SinergiaDeveloper1/IOT_Gym4.0/README.md

# IOT GYM 4.0

IOT project of a 4.0 gym prototype
