SinergiaDeveloper1/IOT_Gym4.0/Relazione/report.pdf

Programmazione per l’IoT - Laurea Magistrale in Informatica Applicata - DiSPeA - Universita degli Studi di Urbino Carlo ` Bo
Data di pubblicazione xx/xx/xxxx - DOI: xxxx/xxxxxxx

# 4.0 Gym Prototype

### Luca Cinti¹

### *, Emanuele Lattanzi²

Sommario
In questo elaborato abbiamo cercato di predisporre un’architettura per la raccolta dei dati in una piccola home gym, innanzitutto per verificare la fattibilita nel reperimento di alcune misurazioni, per poi passare all’analisi dei ` dati raccolti, con l’obiettivo di estrapolare delle metriche significative sia ai fini dell’allenamento, che dello studio delle caratteristiche termiche dell’ambiente.
Keywords
IOT — Arduino — ESP32 — MQTT — Gym Metrics

1Laurea Magistrale in Informatica Applicata, Universita degli Studi di Urbino Carlo Bo, Urbino, Italia `
2Docente di Programmazione per l’Internet of Things, Universita degli Studi di Urbino Carlo Bo, Urbino, Italia ` *Corresponding author: l.cinti@campus.uniurb.it

### Introduzione

L’obiettivo preliminare di questo elaborato era verificare la fattibilita dell’allestimento di un sistema di raccolta dati, in ` una piccola home gym, costruendo l’infrastruttura per far comunicare attraverso diversi protocolli una rete di sensori.

Tra le piu disparate metriche di possibile interesse ai fini ` dello studio di una palestra, sono state scelte due categorie di dati: da un lato i quelli relativi all’ambiente di allenamento, dall’altro i dati sull’esecuzione degli esercizi.
Per il progetto corrente sono state dunque prese in analisi le metriche seguenti:
- temperatura e umidita della stanza, prima durante e ` dopo l’allenamento
- variazione di eCO2 e eTVOC (equivalent Total Volatile Organic Compounds)
- accelerazione del bilanciere durante l’esecuzione di un esercizio campione

### 1. Descrizione dell’ambiente

Funzionale alla comprensione di questo elaborato, e la descri- ` zione dell’ambiente in cui e stata allestita la palestra: si tratta ` di una stanza appartenente ad un vecchio immobile disabitato, appositamente ristrutturata, le cui misure sono 5.05 x 4.95 metri, per un’altezza di 3.86 metri.

L’ambiente presenta una finestra, una porta finestra e un’arcata di ingresso sulla quale sono state applicate due tende, fissate con velcro ai lati del muro, come isolante dal resto del locale, in quanto non sono presenti sistemi di riscaldamento centralizzato. Possiamo vederne una panoramica nell’immagine che segue (Figura 2).

Il primo punto di analisi e dunque diretta conseguenza ` di quanto appena detto: analizzare le performance termiche dell’ambiente, per trovare il miglior metodo di riscaldamento durante i mesi invernali.
Collegato a questo vi e il secondo punto in analisi: riscaldan- ` do un ambiente di circa 96 metri cubici, quanto piu possibi- ` le isolato dal resto del locale, abbiamo ritenuto importante monitorare la qualita dell’aria durante l’allenamento. `

### 1.1 La terza metrica

Come abbiamo visto in precedenza, come terzo oggetto di studio e stata presa in analisi l’accelerazione del bilanciere ` durante l’esecuzione di un esercizio campione.
L’esercizio selezionato e la distensione su panca piana, scelto ` in quanto ci garantiva il maggior grado di controllo sull’esecuzione, essendo uno degli esercizi base di ogni allenamento. Ne possiamo vedere uno schema in Figura 1.

La popolarita di tale esercizio ci garantiva inoltre buone ` potenzialita di espansione di questo studio ad un ampio cam- ` pione di tester, nel caso fossimo riusciti a standardizzare il piu` possibile il metodo di acquisizione dei dati.

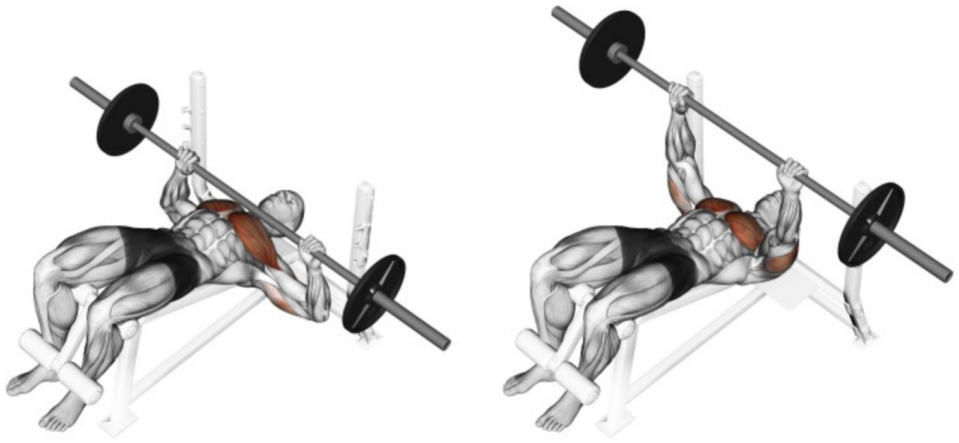
[picture p20: figure]

Figura 1. distensioni su panca piana

### 4.0 Gym Prototype — 2/9

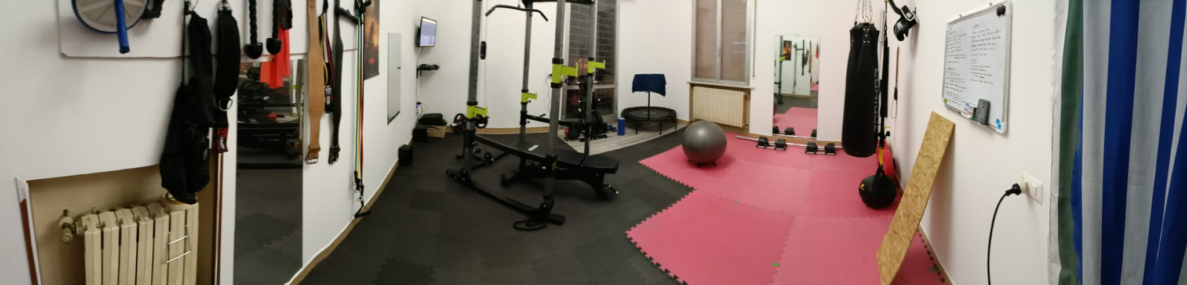
[picture p21: figure]

Figura 2. Visione panoramica dell’ambiente

### 2. Gli strumenti utilizzati

In questa sezione porremo l’attenzione sugli strumenti di indagine utilizzati, sulla loro costruzione, e sulle scelte di progetto e implementazione adottate.

### 2.1 Allestimento dell’infrastruttura

La prima necessita` e stata dunque quella di creare l’infrastrut- ` tura attraverso la quale sarebbe avvenuta la comunicazione dei dati.
A livello di rete e internet sono stati fatti diversi tentativi, prima con due diversi router extender che prolungavano una rete casalinga fino al locale della palestra, e poi con un router con scheda SIM situato direttamente in loco. La prima soluzione e stata scartata in quanto, ad una distanza in linea d’aria dal ` router di casa di circa cinquanta metri, senza considerare i muri, la connessione era troppo instabile.

A questa rete e stato poi collegato un Raspberry Pi 4 che ` ha fatto sia da broker MQTT (di cui parleremo in seguito), che da semplice computer per la raccolta e visualizzazione dei dati, come vediamo in Figura 3.

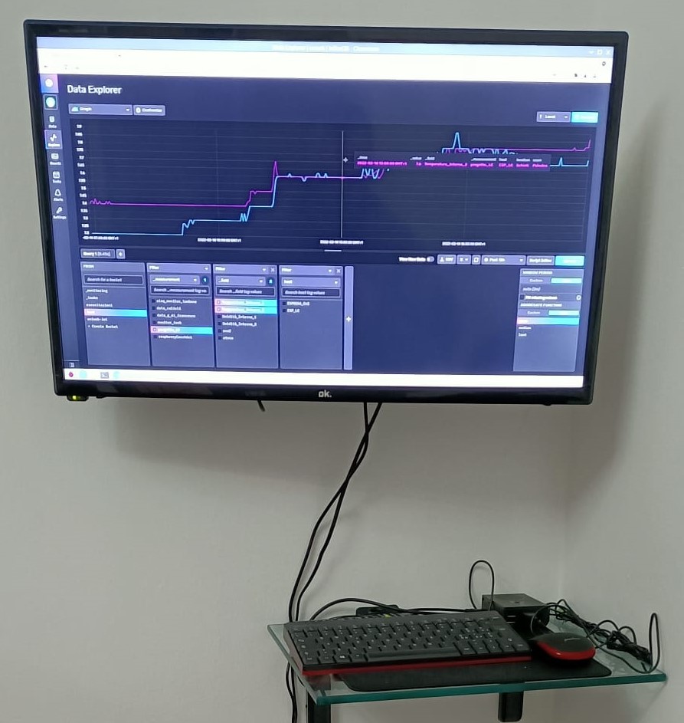
[picture p22: figure]

Figura 3. Raspberry e monitor

### 2.2 I sensori utilizzati

Per raccogliere i dati sono stati utilizzati i seguenti sensori:

- due DHT11 e due DHT22 per temperatura e umidita`
- un CCS811 per eCO2 e eTVOC
- due GY-521 MPU-6050 per l’accelerazione

Si e scelto di collegare gli accelerometri a dei moduli di ` sviluppo ESP32 mini, potendo cos`ı accedere ad un’architettura double core, mentre tutti gli altri sensori sono stati collegati a delle normali ESP8266. Abbiamo adottato sensori DHT11
e DHT22 per temperatura e umidita, potendo cos ` | `ı avere un
confronto nella precisione dei due: vediamo le differenze tra le loro specifiche nella tabella che segue.

Tabella 1. Specifiche DHT

| DHT11 | DHT22
Range umidita | 20-90% | 0-100% `
Precisione umidita | ±5% | ±2% `
Range temperatura | 0-50 °C | -40 +80 °C
Precisione temperatura | ±2% | ±0.5%
Tempo di lettura | 6-10 s | 2 s

Nelle tre immagini che seguono (Figure 4, 5, 6) sono mostrati gli schemi dei circuiti costruiti:


Figura 4. ESP8266 - DHT11/22

### 4.0 Gym Prototype — 3/9

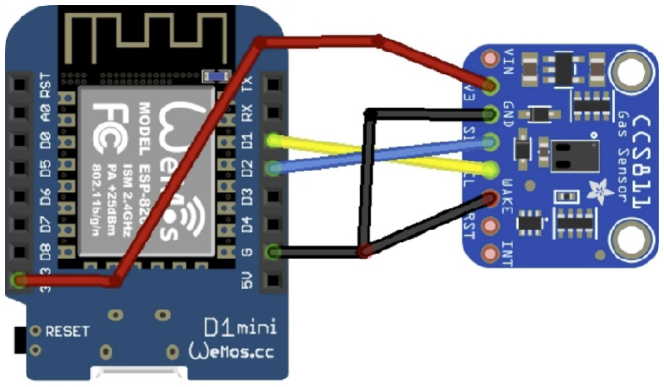
[picture p23: figure]

Figura 5. ESP8266 - CCS811


Figura 6. ESP32 - MPU-6050

### 2.2.1 I sensori per i dati ambientali e il loro obiettivo

Tenendo a mente il primo punto di indagine indicato nell’introduzione, ovvero analizzare i dati ambientali, e doveroso innan- ` zitutto rispondere al perche abbiamo ritenuto delle metriche ´ tuttosommato banali, quali umidita e temperatura, interessanti ` ai fini dell’elaborato.
Come gia detto, il locale non presenta sistemi di riscaldamento ` centralizzato, e, raggiungendo nei mesi invernali temperature interne prossime agli zero gradi centigradi, si e scelto di riscal- ` darlo tramite un generatore di calore a GPL con una potenza di 10 KW, posizionato all’ingresso della palestra, ovvero con la parte frontale dentro il locale, e lo scarico fuori (si faccia riferimento alla Figura 7).

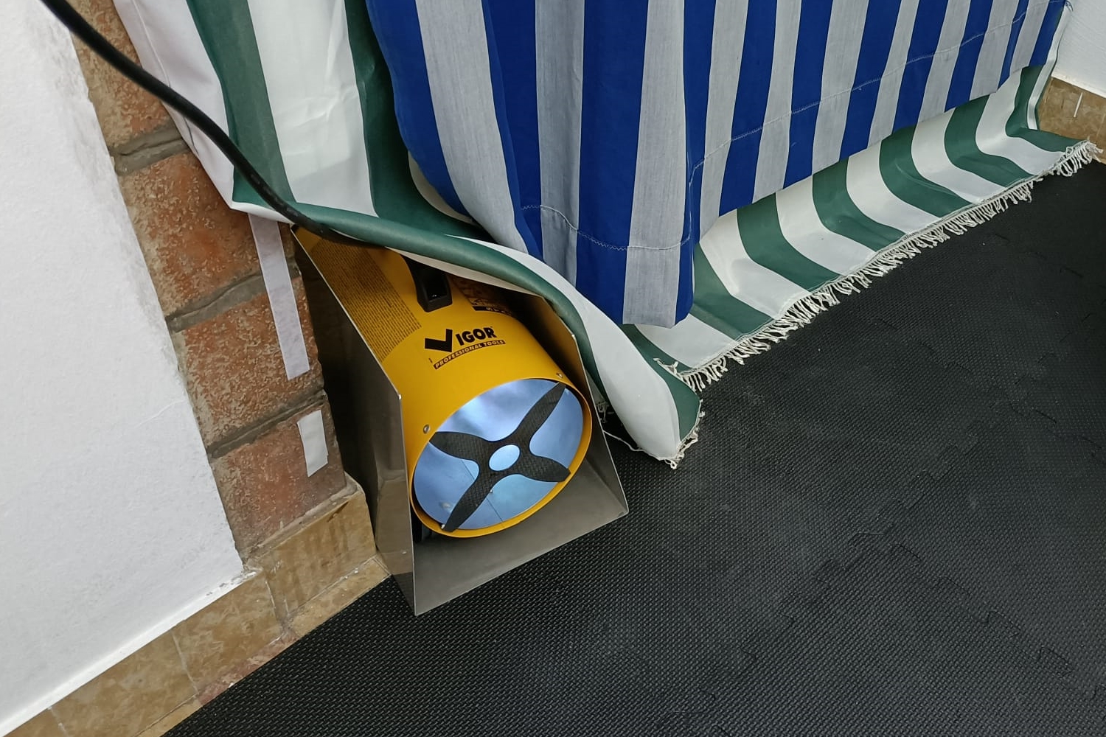
[picture p24: figure]

Figura 7. Termoventilatore GPL

Tuttavia questo presentava altri problemi, sia a livello di sicurezza, trattandosi pur sempre di una combustione in un ambiente chiuso, per quanto la zona di scarico fosse sufficientemente grande e areata, che a livello pratico: il generatore di calore utilizzato e in grado di portare l’ambiente ad una ` temperatura confortevole in tempi contenuti, dell’ordine di dieci/quindici minuti (chiaramente in base alla temperatura di partenza), e dunque necessario spegnerlo per non surriscaldare ` l’ambiente. Questo comporta pero un crollo della temperatura `
pressoche immediato. Si ´ | e scelto dunque di inserire una stufa `
da 3 KW il cui compito e quello di mantenere la temperatura ` costante.
Alla luce di quanto detto, assume ancora piu importanza la se- ` conda metrica oggetto di studio, ovvero la variazione di eCO2 e eTVOC (equivalent Total Volatile Organic Compounds), come monitor indiretto della qualita dell’aria. `
Importante ricordare a tal proposito che il sensore CCS811 non misura direttamente l’anidride carbonica o i composti
organici volatili, ma misura la quantita equivalente di impurit ` | a`
nell’aria per ottenere quelle letture del sensore: in altre parole, il sensore legge determinati dati di qualita dell’aria, tali dati ` possono essere dati dalla presenza di CO2, o da composti organici equivalenti capaci di dare quel tipo di letture. E una ` sottigliezza ininfluente ai fini dell’elaborato, ma per dovere di chiarezza ne abbiamo ritenuto necessaria la precisazione.

Data questa premessa passiamo ora a descrivere le relative scelte di progetto.
Fare uno studio accurato delle performance termiche di un ambiente richiede una grande quantita di dati, sia a livello di ` caratteristiche ingegneristiche e architettoniche dell’ambiente, che dei materiali di costruzione, informazioni alle quali non avevamo completo accesso. Potevamo tuttavia estrapolarle e farne una buona stima, sia attraverso l’analisi in loco di periti tecnici, che dai dati restituiti dai sensori.
Il dato che si e scelto di ricercare ` | e la dispersione del `
calore dall’ambiente, che costituisce un buon aggregato e indice delle performance termiche della stanza.
Per ottenere tale informazione si e scelto di utilizzare i quattro ` sensori DHT come segue: due sono stati posizionati a due angoli della stanza, per ottenere la temperatura media interna, uno fuori dall’edificio per la temperatura esterna, e uno appena fuori dall’ingresso della palestra, comunque in un ambiente interno, ma non riscaldato.
Le due postazioni di rilevamento di temperatura e umidita` esterne alla stanza, non avendo accesso a prese elettriche, sono state implementate con batteria e un con meccanismo di deep sleep per il risparmio energetico. I relativi circuiti sono stati quindi dotati di collegamenti per una batteria da 650 mA e di un jumper per consentire la programmazione del modulo.

### 2.2.2 Gli accelerometri e il loro obiettivo

Un discorso a parte va fatto per gli accelerometri, che per noi costituivano l’argomento di maggiore interesse di questo studio.

### 4.0 Gym Prototype — 4/9

Innanzitutto e necessario chiarire l’obiettivo dell’analisi, ov- ` vero cercare di registrare se, nell’esecuzione di un qualsiasi esercizio che coinvolga il sollevamento di un bilanciere, si rilevano delle imperfezioni, da cogliere attraverso le differenze nelle accelerazioni agli estremi dell’attrezzo: se un accelerometro posto a un estremo del bilanciere, avesse riscontrato accelerazioni diverse da quelle registrate all’estremo opposto, sarebbe stato possibile individuare degli errori nell’esecuzione dell’esercizio, dandoci cos`ı un feedback sulla qualita dello ` stesso, ed eventuali indicazioni per migliorarlo.

Con questo obiettivo in mente abbiamo ritenuto imprescindibile che entrambi i moduli fossero alimentati a batteria, per evitare perturbazioni nelle misurazioni dovute ad eventuali interferenze dei fili di alimentazione. Questo ha pero` aumentato la difficolta nella costruzione del ”sistema accele- ` rometro”, che includendo ora anche una batteria, diventava piu ingombrante e difficilmente stabilizzabile sul bilanciere. `

La soluzione che abbiamo adottato e stata quella di pro- ` gettare delle scatole di plastica, appositamente disegnate in base alle misure del modulo ESP32 col sensore e la batteria, stampate in 3D. Per minimizzare le vibrazioni e i movimenti interni alla scatola, sono stati poi inseriti degli spessori in gommapiuma e dei tappi in plastica, aumentando cos`ı la stabilita` del sistema. Ogni scatola presenta inoltre un foro per accedere alla porta USB dell’ESP32 per le future programmazioni del modulo.
Ne possiamo vedere il risultato nella Figura 8.

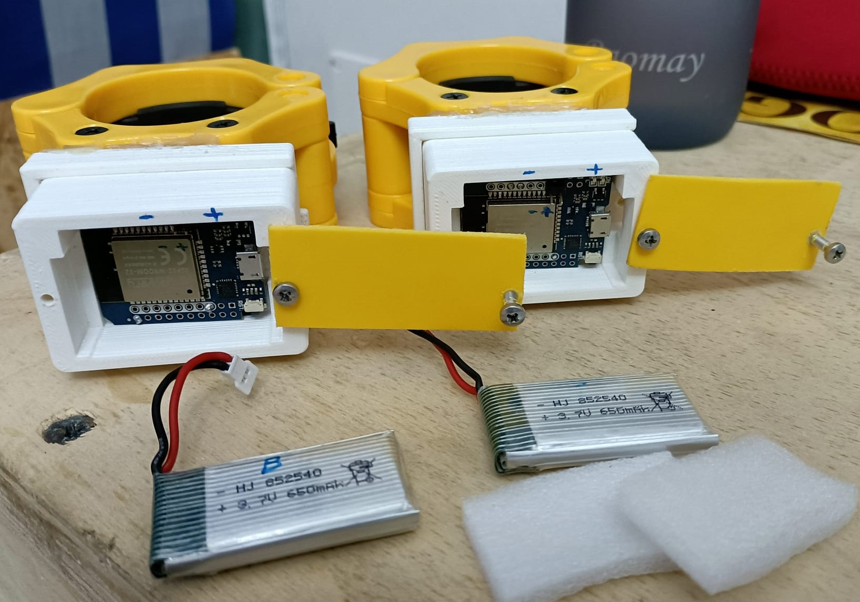
[picture p25: figure]

Figura 8. Scatola con accelerometro

Queste scatole sono state poi fissate agli anelli di bloccaggio dei dischi al bilanciere, come vediamo in Figura 9. Aggiungiamo inoltre che i bilancieri utilizzati per questi test sono bilancieri standard olimpici, di cui riportiamo le misure nell’immagine che segue (Figura 10), che hanno, e questo vedremo in seguito che risultera critico, la caratteristica ` di avere la zona di fissaggio dei pesi capace di ruotare attorno all’asse del bilanciere.
Tale accorgimento tecnico si utilizza per minimizzare la ro-

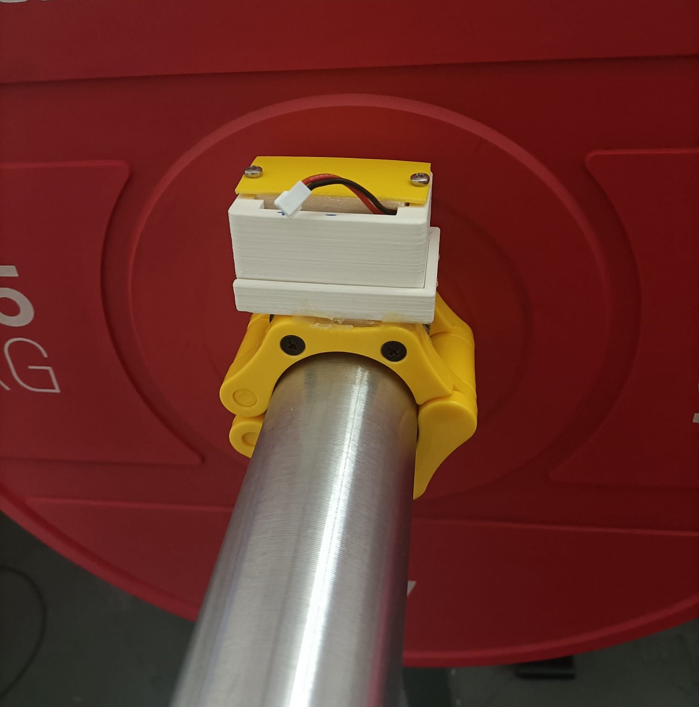
[picture p26: figure]

Figura 9. Anello di bloccaggio dischi su bilanciere

tazione, e le conseguenti accelerazione e variazione di momento angolare del sistema, in fase di movimento del carico: un’improvvisa rotazione del bilanciere attorno al suo asse orizzontale non comporta cos`ı la rotazione dei pesi (o comunque la riduce significativamente), che causerebbe maggiore instabilita nell’esercizio. `

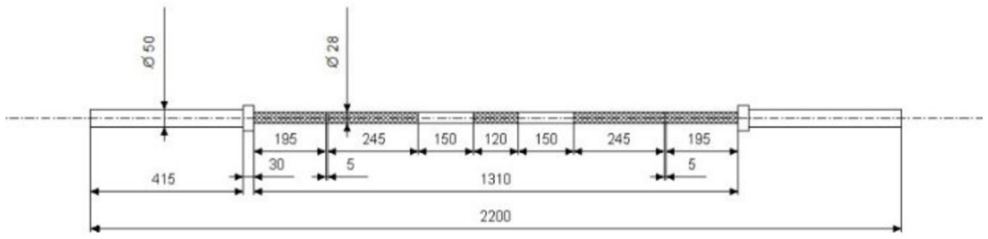
[picture p27: figure]

Figura 10. Misure bilanciere olimpico

Prima di passare alla raccolta e analisi dei dati ci e do- ` veroso aggiungere che tutti i microcontrollori sono stati programmati tramite Arduino. Eventuali particolarita o dettagli ` specifici di implementazione saranno affrontati in fase di analisi dei dati.
Tutto il codice e comunque consultabile nella repository Gi- ` tHub indicata in bibliografia.

### 3. Raccolta dati

I dati sono stati raccolti su un server remoto sul quale e stato ` installato influxdb, un database open source per serie temporali, particolarmente adatto ad applicazioni IOT.

Dei sette sensori di cui si e discusso, cinque comunicava- ` no tramite il modulo WiFi del microcontrollore collegandosi direttamente al server remoto.

Per i due moduli con DHT11 posizionati fuori dalla palestra, quello interno al locale, e quello esterno all’edificio (per maggior chiarezza si faccia riferimento alla pianta del locale in Figura 11) si e optato per una soluzione differen- ` te: essendo alimentati a batteria, abbiamo scelto di utilizzare due tecnologie particolarmente adatte al risparmio energetico.

### 4.0 Gym Prototype — 5/9


Figura 11. Pianta della palestra. Non in scala

Come protocollo di comunicazione si e scelto MQTT (Mes- ` sage Queuing Telemetry Transport), particolarmente meno energivoro del classico WiFi, con il Raspberry Pi 4, come precedentemente detto, che funge da broker, e i due sensori da client.
Per l’invio dei dati su influxdb e stato poi appositamente con- ` figurato su Raspberry un plugin telegraf.
La seconda tecnologia per il risparmio energetico e pi ` u che ` altro un accorgimento a livello implementativo: invece di programmare i sensori con la classica modalita, ovvero in loop `
continuo, si e scelto di adottare il ` | deep sleep, ovvero al termi-
ne di ogni lettura e invio dati, i moduli vengono letteralmente addormentati, lasciando attivo il Real Time Clock (RTC), che si occupa di risvegliare il sistema dopo un intervallo di tempo programmabile.
Nel nostro caso abbiamo visto che la durata della batteria, con questo accorgimento, e praticamente decupliata, passando da ` circa cinque ore a oltre due giorni.
Nell’immagine che segue (Figura 12) vediamo uno dei due sensori in oggetto.

### 4. I dati ambientali durante l’allenamento

Premettiamo che tutti i dati sono disponibili sia in forma aggregata che estensivamente nella repository GitHub indicata in bibliografia, oltre ad essere consultabili direttamente sul server influxdb.

Passiamo ora vedere i dati raccolti, relativi ad una data campione particolarmente indicativa, in cui e stata utilizzata ` la palestra. Alleghiamo i grafici estratti da influxdb nelle immagini che seguono (Figure 13, 14, 15), e condensati nella

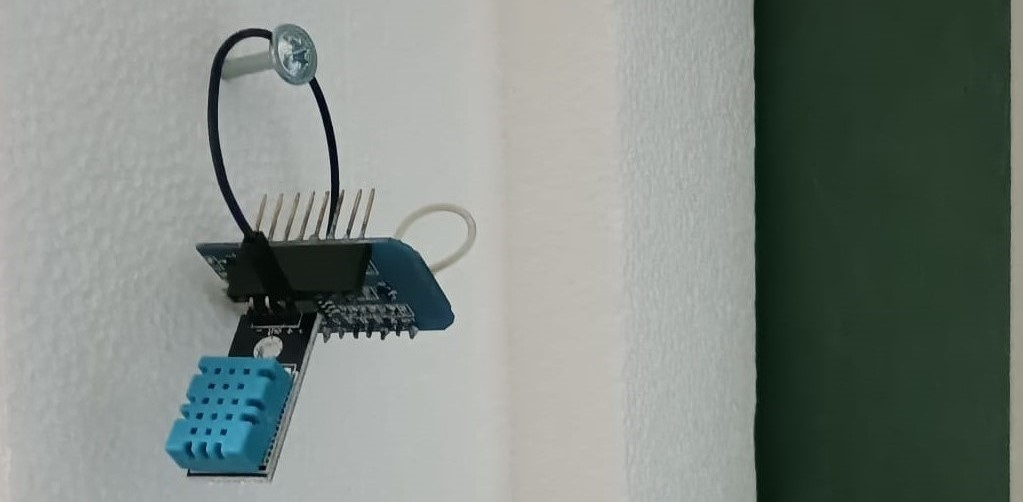
[picture p28: figure]

Figura 12. Sensore DHT11 fuori dall’ingresso della palestra

tabella in Figura 16.


Figura 13. Temperatura in gradi Celsius


Figura 14. Umidita in percentuale `

Le linee azzurre e viola sono relative ai due sensori interni, quella arancio al sensore fuori dall’ingresso, quella magenta al sensore esterno.

### 4.1 Analisi dei dati ambientali

Iniziamo questa analisi da una descrizione piu approfondita ` dei grafici precedentemente allegati.
Come possiamo vedere in tabella, sono stati indicati dei timestamp significativi:
- 18:55, inizio dell’allenamento e accensione di stufa e generatore di calore
- 19:08, spegnimento del generatore di calore

### 4.0 Gym Prototype — 6/9


Figura 15. eCO2 in ppm e eTVOC in ppb


Figura 16. dati condensati in timestamp significativi

- 19:30 e 19:01, due intertempi per mostrare l’andamento durante l’allenamento
- 20:27, spegnimento della stufa
- 20:37, fine allenamento

La variazione piu importante in tutti gli indicatori avviene ` mentre il generatore di calore a GPL e acceso; vediamo infatti ` che le temperature interne hanno una rapidissima crescita,
parallela ad un crollo dell’umidita. Molto positivo ` | e inoltre `
il fatto che la qualita dell’aria non degradi troppo significati- ` vamente, registrando solo un picco nella quantita di anidride ` carbonica (e/o suoi composti equivalenti), comunque inferiore a qualla generata dal metabolismo durante l’allenamento. Particolarmente interessante risulta l’andamento della temperatura registrata dal sensore posizionato appena fuori dall’ingresso della stanza (linea arancio del grafico in Figura 13), che in questa fase presenta a sua volta un aumento, mostrando chiaramente, come era intuibile, i problemi di isolamento termico dovuti alla separazione degli ambienti ottenuta soltanto tramite due tende in tessuto sintetico.
Il discostamento tra i valori della temperatura interna e invece ` spiegato dall’orientamento della stufa elettrica, che evidentemente genera un flusso di aria calda piu indirizzato verso uno ` dei sensori.

Dallo spegnimento del generatore GPL in poi, si nota chiaramente una discesa della temperatura della palestra fino ad un punto di stabilita, ovvero una situazione in cui il calore ` generato dalla stufa elettrica e dal metabolismo di chi si allena, e eguagliato dal calore disperso. `

I due sensori esterni alla palestra mostrano un andamento banale, ovvero di graduale stabilizzazione attorno alla temperatura atmosferica per il sensore esterno, e alla temperatura dell’edificio per quello fuori dall’ingresso. Per questi ultimi sensori non e di interesse, ai fini dell’elaborato, l’andamento ` dell’umidita.`
Torna invece ad essere di particolare interesse notare come le curve di CO2 e umidita abbiano un andamento correlato: ` i loro aumenti sono dovuti al metabolismo di chi si allena, che emette costantemente anidride carbonica, vapore acqueo e composti organici di varia natura.

Nella fase terminale dell’allenamento sono da registrarsi due fattori: da un lato lo spegnimento della stufa causa l’ovvio abbassamento della temperatura interna e la sua convergenza verso un unico valore; dall’altro vediamo un difficilmente
spiegabile aumento sia dell’umidita che di CO ` | 2 e TVOC. Que-
sti sono invece dovuti alla natura dell’allenamento svolto, che prevedeva una forte componente aerobica sul finale, ben testimoniata dai grafici riportati.

### 4.2 Analisi delle accelerazioni

A differenza del paragrafo precedente, per quanto riguarda gli accelerometri i grafici verranno analizzati singolarmente, in quanto ognuno, pur facendo riferimento alla stessa tipologia
di esercizio, eseguito nel modo piu controllato possibile, ` | e`
specchio di differenti implementazioni a livello di codice, ogni volta alla ricerca di maggior pulizia e indicativita nei dati ` raccolti.
Ogni esercizio e stato svolto in blocchi di quattro serie da ` otto/dieci ripetizioni ognuna, con circa 90 secondi di pausa tra una serie e l’altra (col termine ”ripetizione” si intende una discesa e risalita complete del bilanciere).
Prima di passare all’analisi di grafici, schematizziamo i dettagli generali della prima implementazione, evidenziandone in seguito solo le modifiche sostanziali. Il codice completo e la sua storia, al solito, e disponibile nella repository GitHub. `
- all’accensione del sensore seguono dieci secondi di ”buffer” in cui si permetteva all’utente di posizionare e stabilizzare il modulo. Terminata questa fase di attesa, veniva effettuata la tara sull’accelerazione, e la sua normalizzazione attorno allo zero (semplicemente veniva sottratta lungo l’asse verticale, l’accelerazione di gravita)`
- il sensore entra nel ciclo While-Loop, all’interno del quale, ogni centesimo di secondo, vengono raccolte le accelerazioni lungo i tre assi cartesiani e inserite in tre rispettivi array, dimensionati in modo da contenere 40 misurazioni
- una volta riempiti i buffer, il sensore procede a calcolare la media delle accelerazioni lungo i tre assi, per poi sommare tali medie vettorialmente, tramite il teorema di Pitagora in tre dimensioni
- invio del dato al server con influxdb

### 4.0 Gym Prototype — 7/9

Gli accelerometri e i microcontrollori utilizzati permettono una lettura dei dati ogni millesimo di secondo, ma si e` scelto, per non stressare troppo il modulo (causandone surriscaldamento, e relativo degradarsi della precisione), di effettuarne una ogni centesimo di secondo. Dilatare ulteriormente
la finestra temporale e stato tuttavia scartato perch ` | e una disten- ´
sione su panca piana, nelle sue fasi di concentrica e eccentrica (salita e discesa del bilanciere), richiede tra gli uno e i due secondi, di conseguenza abbiamo ritenuto opportuno avere circa 150 letture per ogni esecuzione.
Si nota subito che l’implementazione piu ovvia, ovvero quel- ` la che scrive su database ad ogni lettura (ogni centesimo di secondo) e stata scartata per motivi tecnici, ritenedo il tempo ` di invio dato di gran lunga superiore a quello di acquisizione dello stesso: inviare la lettura via internet e scriverla sul server remoto, richiede sicuramente molto piu di un centesimo di ` secondo, oltre ad essere un tempo variabile.

Si e scelto dunque di aggregare le letture nel loro valore ` medio, a partire dagli array sopra descritti, dimensionati tranmite una stima, in modo tale da rendere il tempo di elaborazione e invio a database non in grado di sporcare eccesivamente il dato.


Figura 17. 21 febbraio 2022, prima implementazione

Con riferimento alla Figura 17, analizziamo questa lettura della prima implementazione.
Sull’asse delle ascisse e rappresentato il tempo, mentre sulle ` ordinate abbiamo l’accelerazione in m/s

2
. Il grafico puo`
essere diviso in due parti da quel picco attorno alle 19 e 11, registrato da entrambi gli accelerometri, seguito dalla loro momentanea disconnessione, fino alle 19 e 15. Le curve successive, e vedremo che questo sara un problema ricorrente ` che tratteremo nelle conclusioni, presentano un andamento caotico e di difficile interpretazione.
La prima parte del grafico tuttavia mostra chiaramente tre serie di allenamento (zone ”disturbate” del grafico), intervallate dai detti 90 secondi di pausa in cui entrambe le accelerazioni destra e sinistra rimangono costanti. Da un lato e positivo il ` fatto che gli accelerometri scrivano correttamente le proprie letture, ma i dati relativi alla singola esecuzione, cos`ı come della serie intera, non offrono un andamento tale da trarre conclusioni o analisi.

Passiamo dunque al grafico della seconda implementazione, che segue in Figura 18.


Figura 18. 3 marzo 2022, seconda implementazione

In questa fase erano stati fatti due importanti aggiornamenti al codice: in prima istanza era stata rimossa la tara alle misurazioni lungo gli assi cartesiani, in quanto ogni rotazione lungo l’asse orizzontale del bilanciere la rendeva del tutto inutile. Veniva comunque mantenuta la sottrazione dell’accelerazione di gravita dal vettore risultante. Inoltre era stata ` aumentata la granularita dei dati inviati, accorpando le mi- ` surazioni in array di 25 elementi, corrispondenti ad un invio di dati nominale ogni quarto di secondo (ricordando che 25 elementi corrispondono a 250 millesimi di secondo).
Il grafico, che questa volta riporta una sola serie dell’esercizio, mostra sicuramente un andamento piu chiaro e coerente ` rispetto a quanto ricercato, in particolare le ultime tre ripetizioni sono ben rappresentate da aumenti e diminuzioni di accelerazione abbastanza allineati tra i due sensori.
Si puo inoltre notare che l’accelerazione media in fase di di- ` scesa non raggiunge mai 1 g, a testimonianza di una discesa a velocita controllata del carico, contro una risalita abbastanza ` veloce, la cui accelerazione raggiunge i 10 m/s

2

Nonostante l’evidente miglioramento, il risultato non e` stato ritenuto soddisfacente anche alla luce dell’analisi dei dati tabellati (consultabili nel file allegato ACC ELAB 2022-03-03.csv), che continuano a mostrare un evidente scostamento tra i valori dei due accelerometri, anche in presenza di un movimento costante e controllato del bilanciere. Oltre a questo disturbo nelle misurazioni, risultava nuovamente evidente il progressivo degradarsi delle letture col passare dei minuti.

Con il successivo aggiornamento del codice e stata nuova- ` mente modificata la dimensione dell’array, portandola a 30, diluendo in minima parte la frequenza di invio, con l’obiettivo di diminuire la perdita di dati inviati, che a questo punto iniziavamo a riconoscere come potenziale causa dello scostamento tra i dati registrati dai due accelerometri. Abbiamo inoltre raffinato il calcolo della media, effettuandolo non piu sulle ` singole componenti prima di ricavare il vettore risultante, ma calcolando per ogni misurazione il vettore-somma, e successivamente la media tra tutti i vettori risultanti cos`ı ottenuti. Si e`

### 4.0 Gym Prototype — 8/9

inoltre ritenuta superflua la normalizzazione attorno allo zero dell’accelerazione, che e stata rimossa. `


Figura 19. 21 aprile 2022, terza implementazione


Figura 20. zoom sulla prima serie

In Figura 19 vediamo come gli aggiornamenti apportati abbiano reso i grafici molto piu ”armonici” rispetto alla prima ` versione del codice, pur mantenendo l’evidente degradarsi delle letture con il tempo. Tuttavia lo zoom sulla singola serie (Figura 20) evidenzia come ancora una volta i dati ottenuti non siano coerenti con l’esecuzione controllata dell’esercizio, dalla quale ci si aspetterebbero due curve circa sovrapponibili, o al piu lievemente discostate lungo l’asse del tempo. `

### 4.2.1 L’ultima versione del codice degli accelerometri

Come nella precedente versione abbiamo di nuovo aumentato la dimensione dell’array a 35, con lo stesso obiettivo sopra descritto. In questa implementazione sono state tuttavia introdotte due ulteriori modifiche sostanziali:

- si e scelto di introdurre un’ulteriore metrica oltre alla ` media delle accelerazioni, ovvero il valore massimo di ogni array. Questo semplicemente alla ricerca di nuovi dati che potessero meglio offrirsi a interpretazione. Possiamo anticipare che gia dopo i primi test era stata ` riscontrata un’anomalia sulle letture dei sensori, che sporadicamente registravano dei valori di accelerazione massima non plausibili (in modulo fino a 80 m/s

2
),
anomalia che ci ha mostrato un probabile malfunzionamento dei sensori, aggirato con l’inserimento a livello di codice di valori soglia delle misurazioni, oltre i quali il dato viene scartato. Trattandosi comunque di
un’eventualita non troppo frequente, ci ` | o non presenta `
ripercussioni significative sulla sincronia delle letture dei due sensori.
- abbiamo deciso di parallelizzare i task principali dei moduli, sfruttando l’architettura dual core delle ESP32. Invece di lavorare con il classico while-loop, in fase di setup del microcontrollore vengono associati due task ai due core, eseguiti a loro volta su cicli-for infiniti. Uno dei due processori si occupa di raccogliere i dati, scrivendoli su un buffer condiviso, l’altro controlla, come da paradigma produttore-consumatore, se ci sono dati pronti per essere elaborati (calcolo della media e del massimo), e li invia. Il primo core, una volta riempito il primo array, passa a scrivere i dati su un secondo buffer.
L’idea di fondo e quella di permettere ad un core di ` effettuare continuamente le misurazioni, mentre all’altro di provvedere ai calcoli sui dati e al successivo invio. Cos`ı facendo, ipotizzando l’assenza di problemi di perdita dati in fase di comunicazione col server, si va ad annullare il tempo morto al termine del riempimento dell’array, consentendo una scrittura omogenea e continua sul database.

Possiamo osservare nelle immagini che seguono i grafici risultanti (Figure 21 e 22), di nuovo relativi ad una sola serie.


Figura 21. zoom sulla prima serie


Figura 22. zoom sulla prima serie

### 4.0 Gym Prototype — 9/9

Purtroppo ancora una volta, nonostante l’ulteriore accorgimento nell’utilizzo di un’interpolazione morbida nella generazione delle curve (selezionabile nelle impostazioni dei grafici di influxdb), ci troviamo di fronte a dati di difficile interpretazione, se non addirittura privi di significato.

### 5. Analisi finale e conclusione

### 5.1 Risultati delle letture di temperatura e umidita`

Figura 23. zoom sulla prima serie

### 5.1.1 Subsubsection

### 6. Conclusioni

### Riferimenti bibliografici
