SinergiaDeveloper1/IOT_Gym4.0/Relazione/Figures/view.jpg

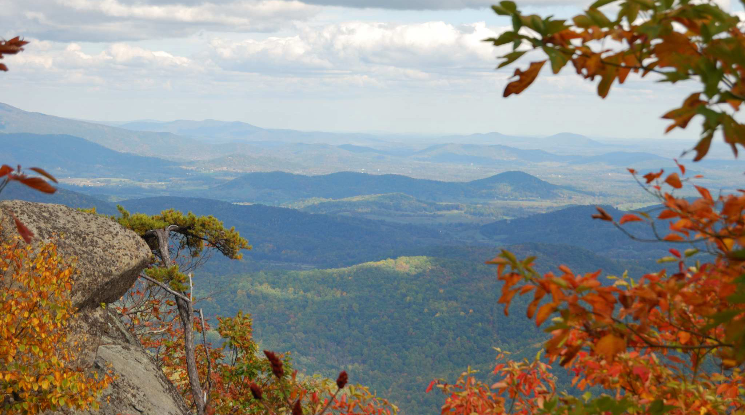
Relazione/Figures/view.jpg
