SinergiaDeveloper1/IOT_Gym4.0/Relazione/Allegati/Analisi_Palestra_Ingg_LauraOcchialini_SandroDelPriore.pdf

I

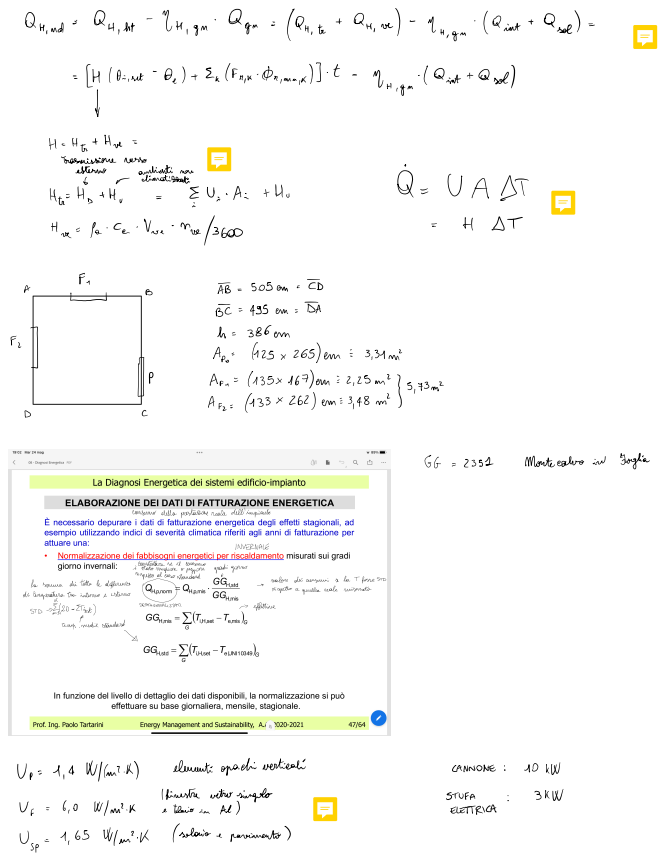
[picture p30: page 1]
Quindi Ah ht; Magni hint; iii; Afa 135 167em 2,25m 5,73mi; Montecalvo in Foglia; elementiMedi Mth; CANNONE; aaaa; STUFA

H Aint be In Frik rimniklI.t Magni hint sol

H Hattre
trasmissioneverso
Hetfirfmen Ai H
ne laica ke map

thinestre vetrosingolo
e telaio in Al

Ve 6,0 Wma
Usp 1,65 Wm'ik solaioe pavimento

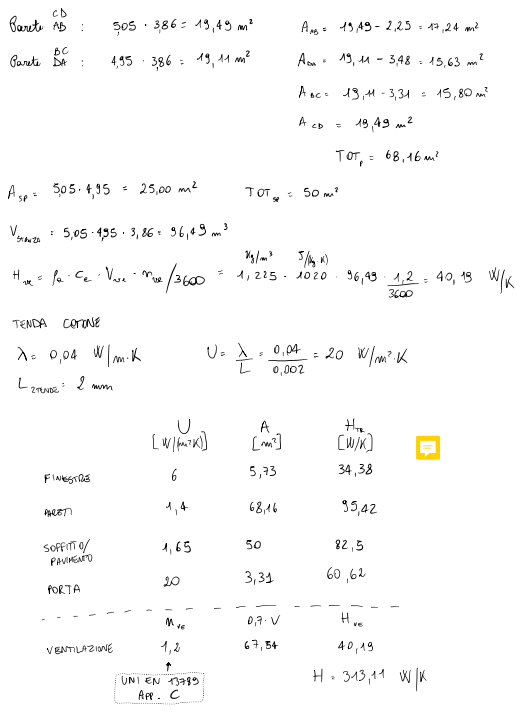
[picture p31: page 2]
Parete I; Aaa 19,49 2,25 17,24mi; Parete DI; Ada 19,11 3,48 15,63m; Abc 19,11 3,31 15,80m; Aed; TOT 68,16m; Asp 5,05 4,95; TOT; stanza; Hai la.ca Vue rue 3600; III 96,49; g 40,19 WIK; TENDA COTONE; D 0,04 W mik; Vet fi 20 Ntmk; Latente 2mm; Hir; WIND; NIK; 34,38 FINESTRE; PARETI; SIETE; PORTA; VENTILAZIONE; unjjn.IE; H 313,11 WIK

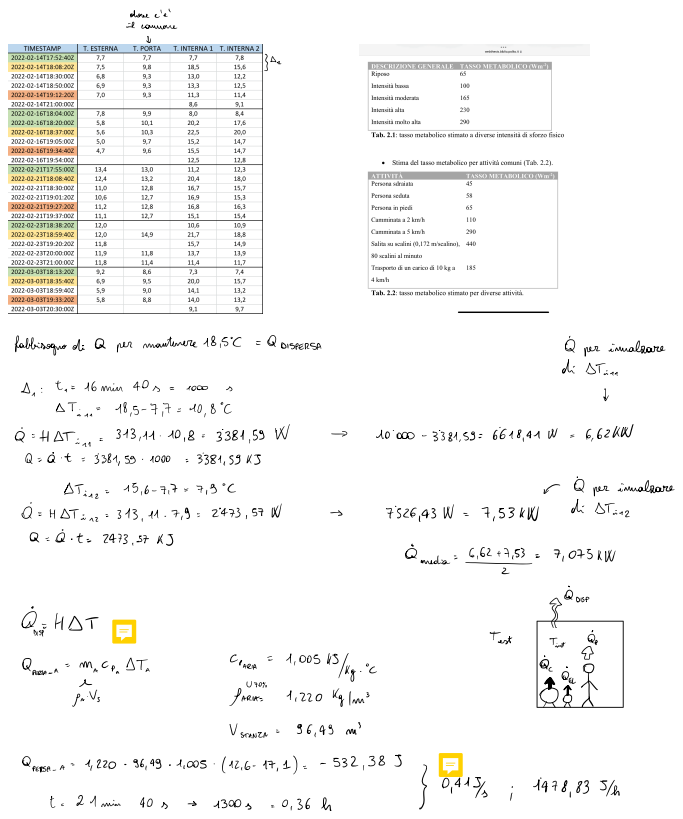
[picture p32: page 3]
dovec'è il; cognome; fabbisognodi Q per mantenere18,5C; dispersa; perinnalzare; tre 16min40s 1000 s; stima; Atia 18,5 7,7 10,8 C; A HAT; Q Hatin 313,11 7,9 2473,57W; di Atina; i media Gatti 7,075kW; fase Q HAT; Test; tu gli; Qpasa.at MacraITA; l'aria 100543kg c; foggy IV; farti 1,220 kgun; Usanza 96,49 mi; Persa A 1220 96,49 1,005 12,6 17,1; te 21min 40s
