SinergiaDeveloper1/IOT_Gym4.0/(commit log)

2022-03-03 tolta la tara, aggiunta accelerazione MAX assieme alla media.
2022-03-10 stabilizzato il wifi (spero)
2022-04-05 inserito multicore negli accelerometri
2022-06-13 13 giugno - punto di partenza
2022-06-26 piccole modifiche
    [2022-02-16_influxdb_data - Per Analisi.xlsx, Analisi_Ingg_LauraOcchialini_SandroDelPriore.xlsx, Raccolta dati.xlsx]
